iveyj1/nrfstick/data/download.pdf

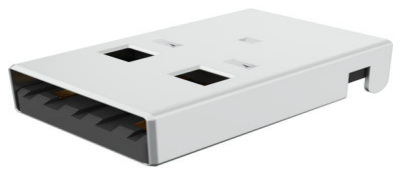
[picture p1: figure]

Part Number : 480372100 (https://www.molex.com/en-us/products/part-detail/480372100)
Product Description : Universal Serial Bus (USB) Shielded I/O Plug, Type A, Right-Angle, Surface Mount, Straight Tab 4.80mm, 0.76µm Gold (Au) Plating, PCB Thickness 1.60mm, Tape on Reel Package, Lead-Free Series Number : 48037
Status : Active
Product Category : I/O Connectors

### Documents and Resources

Drawings
480372100_sd.pdf (https://www.molex.com/content/dam/molex/molex-dot-com/products/automated/en-us/salesdrawingpdf/480/48037/480372100_sd.pdf)
PK-48037-210-002.pdf (https://www.molex.com/content/dam/molex/molex-dot-com/products/automated/en-us/packagingdesigndrawing/480/48037/PK-48037-210-002.pdf)
3D Models and Design Files STEP (https://www.molex.com/bin/molex/traceparts/cad-request?partNumber=480372100&cadFormatId=659) AP242 (https://www.molex.com/bin/molex/traceparts/cad-request?partNumber=480372100&cadFormatId=659)
SOLIDWORKS (https://www.molex.com/bin/molex/traceparts/cad-request?partNumber=480372100&cadFormatId=7)
Creo (https://www.molex.com/bin/molex/traceparts/cad-request?partNumber=480372100&cadFormatId=16)
Symbol (https://www.molex.com/en-us/products/part-3d-cad/480372100) and (https://www.molex.com/en-us/products/part-3d-cad/480372100) Footprint (https://www.molex.com/en-us/products/part-3d-cad/480372100) (Multi- (https://www.molex.com/en-us/products/part-3d-cad/480372100)Format) (https://www.molex.com/en-us/products/part-3d-cad/480372100) Specifications
PS-48037-001-001.pdf (https://www.molex.com/content/dam/molex/molex-dot-com/products/automated/en-us/productspecificationpdf/480/48037/PS-48037-001-001.pdf)
TS-48037-001-001.pdf (https://www.molex.com/content/dam/molex/molex-dot-com/products/automated/en-us/productspecificationpdf/480/48037/TS-48037-001-001.pdf)

### Product Environment Compliance

Compliance
GADSL/IMDS | Compliant with Exemption 33
China RoHS | per SJ/T 11365-2006
EU ELV | Not Relevant
Low-Halogen Status | Low-Halogen per IEC 61249-2-21
REACH SVHC | Not Contained per D(2025)7771-DC (04 Feb 2026)
EU RoHS | Compliant per EU 2015/863

Compliance (https://www.molex.com/en-us/product-compliance#pn=480372100) Statements (https://www.molex.com/en-us/product-compliance#pn=480372100)
EU RoHS
REACH SVHC
Low-Halogen
Industry (https://www.molex.com/en-us/industry-compliance?pn=480372100) Documents (https://www.molex.com/en-us/industry-compliance?pn=480372100)
IPC 1752A Class C
IPC 1752A Class D
Molex Product Compliance Declaration IEC-62474
chemSHERPA (xml)
Substances (https://www.molex.com/en-us/substances-of-interest?pn=480372100) of (https://www.molex.com/en-us/substances-of-interest?pn=480372100) Interest (https://www.molex.com/en-us/substances-of-interest?pn=480372100)
PFAS
EU (https://www.molex.com/en-us/rohs-pdf?pn=480372100) RoHS (https://www.molex.com/en-us/rohs-pdf?pn=480372100) Certificate (https://www.molex.com/en-us/rohs-pdf?pn=480372100) of (https://www.molex.com/en-us/rohs-pdf?pn=480372100) Compliance (https://www.molex.com/en-us/rohs-pdf?pn=480372100) Additional (https://www.molex.com/en-us/about/product-compliance) Product (https://www.molex.com/en-us/about/product-compliance) Compliance (https://www.molex.com/en-us/about/product-compliance) Information (https://www.molex.com/en-us/about/product-compliance)

### Part Details

General
Status | Active
Category | I/O Connectors
Series | 48037
Description | Universal Serial Bus (USB) Shielded I/O Plug, Type A, Right-Angle, Surface Mount, Straight Tab 4.80mm, 0.76µm Gold (Au) Plating, PCB Thickness 1.60mm, Tape on Reel Package, Lead-Free
Application | Wire-to-Board
Comments | Straight Tab 4.80mm
Component Type | Plug
Product Name | USB
Standard | USB 2.0
Type | A
UPC | 822350302760

Electrical
Current - Maximum per Contact | 1.5A
Shielded | Yes
Shield Type | Full Shield

Voltage - Maximum | 150V AC (RMS)

Physical
Circuits (Loaded) | 4
Circuits (maximum) | 4
Color - Resin | Black
Gender | Male
Keying to Mating Part | Yes
Lock to Mating Part | Yes
Material - Metal | Brass
Material - Plating Mating | Gold
Material - Plating Termination | Tin
Mounting Style | Top-Mount
Net Weight | 1.908/g
Number of Rows | 1
Orientation | Right Angle
Packaging Type | Embossed Tape on Reel
Panel Mount | Yes
PCB Locator | Yes
PCB Retention | Yes
PCB Thickness - Recommended | 1.60mm
Pitch - Mating Interface | 2.00mm, 2.50mm
Pitch - Termination Interface | 2.00mm, 2.50mm
Plating min - Mating | 0.762µm
Polarized to Mating Part | Yes
Polarized to PCB | Yes
Ports | 1
Temperature Range - Operating | -20° to +85°C
Termination Interface Style | Surface Mount
Waterproof / Dustproof | No

### Mates With / Use With

Mates with Part(s)
Description | Part Number

Mates With | USB Type A Receptacle
| This document was generated on Jun 28, 2026
