iveyj1/nrfstick/kikit/nrfstick-panel.png

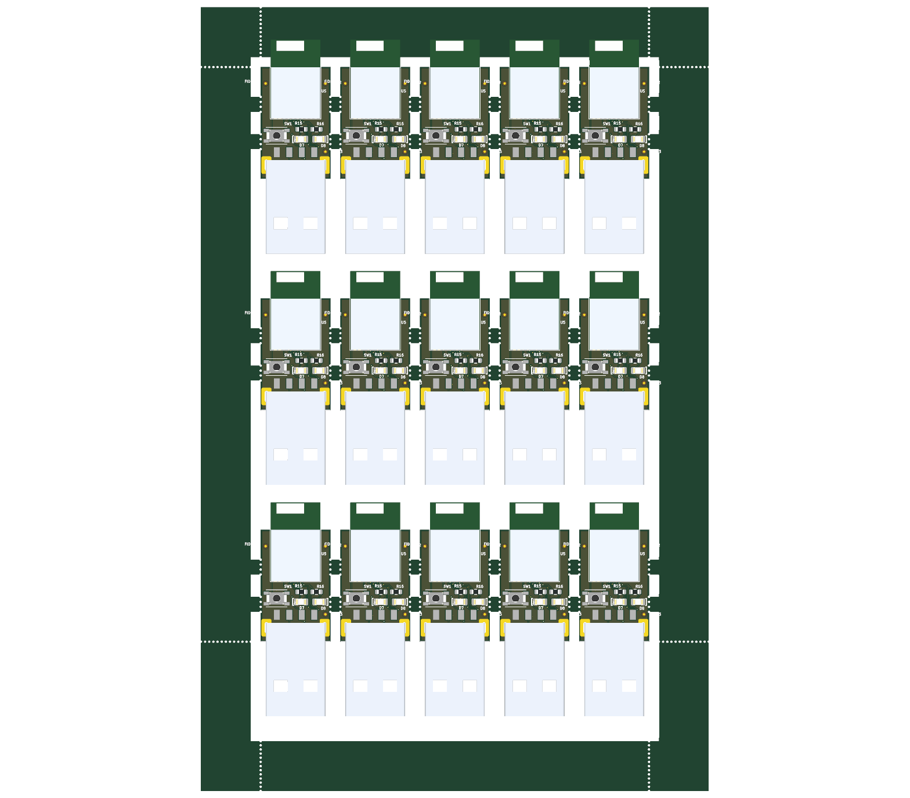
kikit/nrfstick-panel.png
