iveyj1/nrfstick/cad/adamtech_usb_ap_s_ra_smt.step

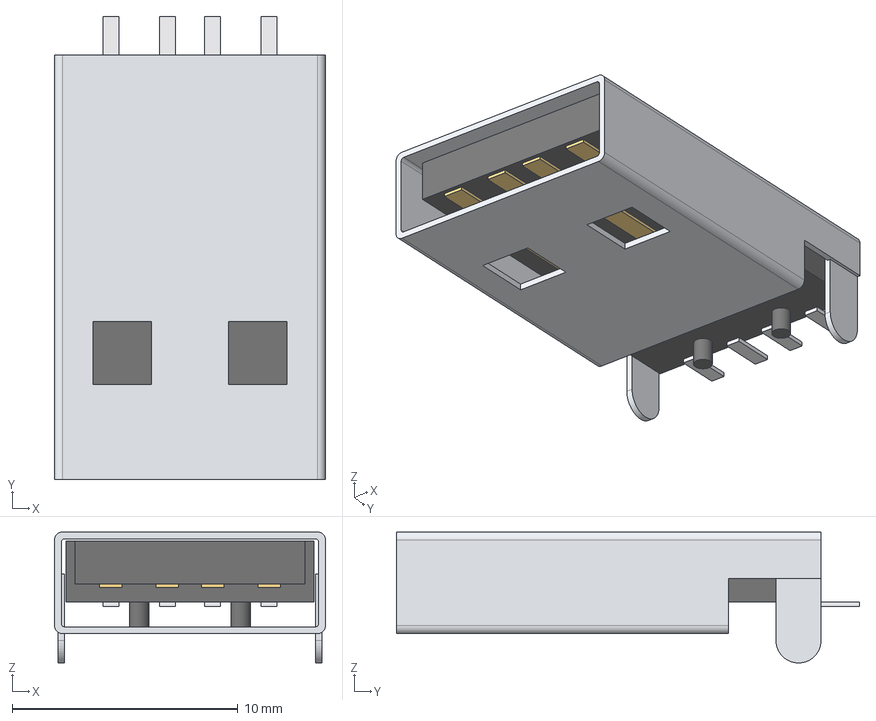
[picture p3: CAD file, 2026-09-16]
cad/adamtech_usb_ap_s_ra_smt.step
12.0 x 20.5 x 5.80 mm
nickel_shell
black_insulator
tin_tail_1
gold_contact_1
tin_tail_2
gold_contact_2
tin_tail_3
gold_contact_3
tin_tail_4
gold_contact_4
