iveyj1/nrfstick/kikit/cad/molex_480372100.step

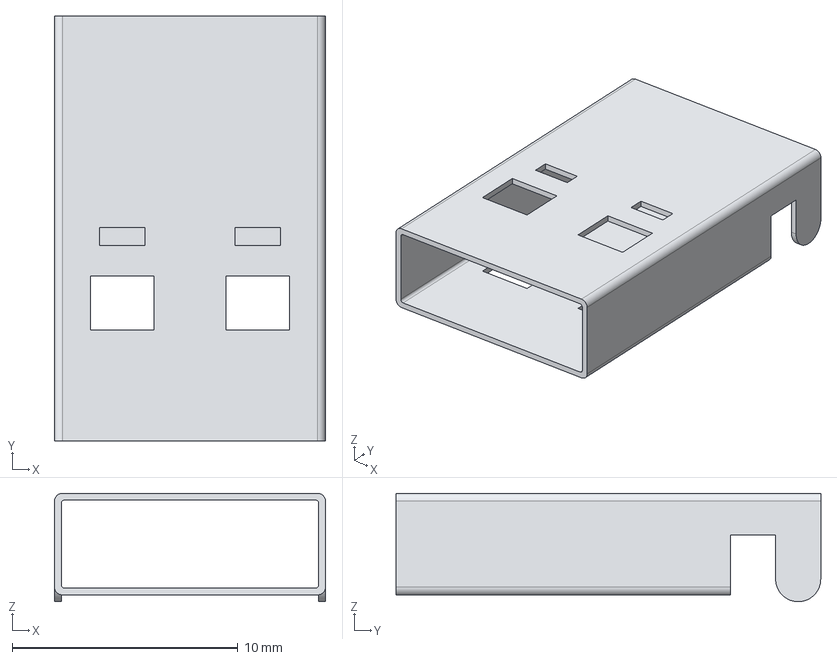
[picture p4: CAD file, 2026-09-16]
kikit/cad/molex_480372100.step
12.0 x 18.8 x 4.80 mm
