iveyj1/nrfstick/cad/fanstel_bm15c.step

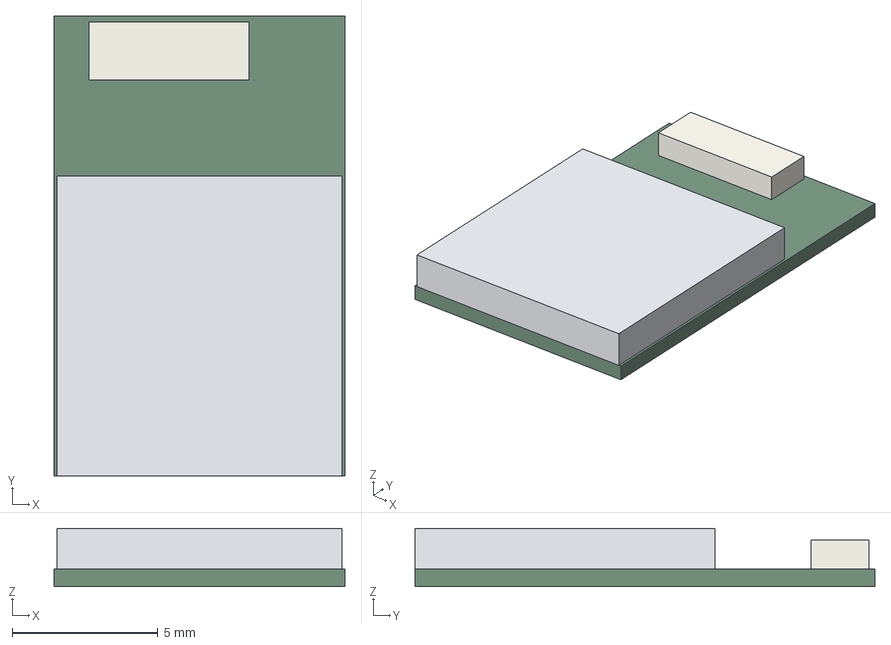
[picture p5: CAD file, 2026-09-16]
cad/fanstel_bm15c.step
10.0 x 15.8 x 2.00 mm
module_PCB
RF_shield
chip_antenna
