iveyj1/nrfstick/cad/nrfstick_board_support.step

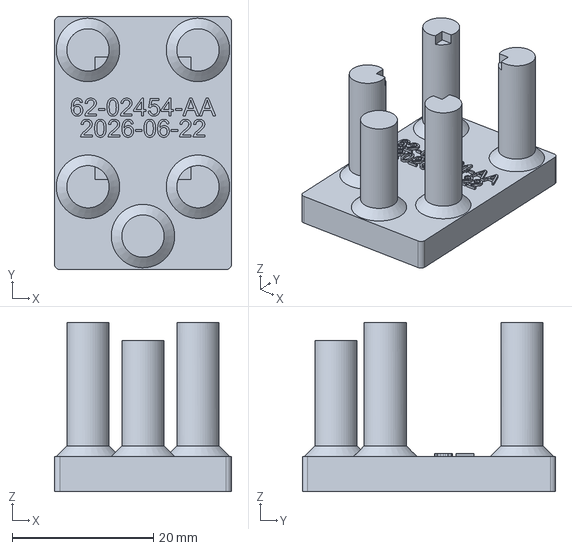
[picture p6: CAD file, 2026-08-20]
cad/nrfstick_board_support.step
25.1 x 35.9 x 24.0 mm
