iveyj1/nrfstick/cad/nrfstick_pcb_preview.step

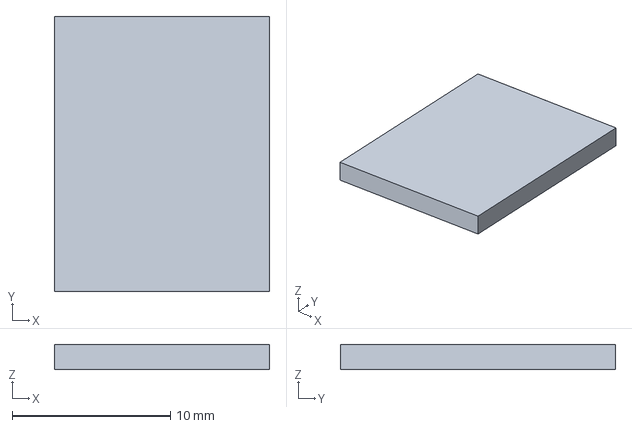
[picture p7: CAD file, 2026-08-20]
cad/nrfstick_pcb_preview.step
13.6 x 17.4 x 1.60 mm
