iveyj1/nrfstick/(list of files, cad)

Other CAD files:
cad/nrfstick_board_support.3mf
