iveyj1/nrfstick/(list of files, drawings)

Other design files:
freerouting.dsn
temp-freerouting.dsn
