iveyj1/nrfstick/nrfstick.kicad_pcb

## KiCad design nrfstick.kicad_pcb (2026-09-16)

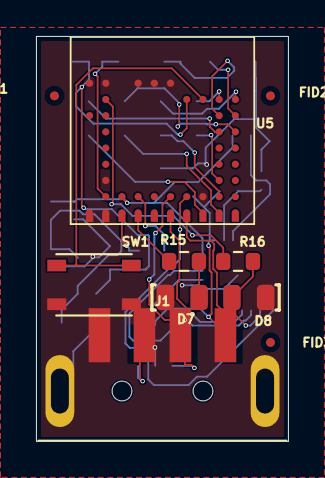
[picture p8: board nrfstick.kicad_pcb from above]

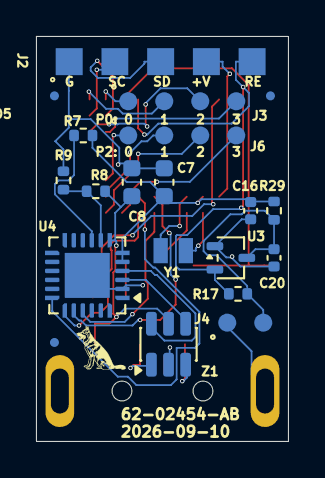
[picture p9: board nrfstick.kicad_pcb from below]

Board: 4 copper layers, 14.0 x 22.5 mm, 31 parts (21 on the bottom side), 32 nets.

Parts:
C7, C8: 4.7uF/10V; C_0603_1608Metric
C16, C20: 0.10uF/50v; C_0402_1005Metric
D7: BLUE LED; LED_0805_2012Metric
D8: RED LED; LED_0805_2012Metric
FID1, FID2, FID3, FID4, FID5, FID6: Fiducial; Fiducial_0.5mm_Mask1mm
H2: Shepherd; shepherd-neg
J1: USB_A; USB_A_AdamTech_USB-AP-S-RA-SMT
J2: programming conn; program-nrf
J3: IO00; Conn_Pads_1x04_P2.00mm_D1.00mm
J4: Reset; Conn_Pads_2x01_P2.00mm_D1.00mm
J6: UART2; Conn_Pads_1x04_P2.00mm_D1.00mm
R7, R29: 1.00k; R_0402_1005Metric
R8: 22.1k; R_0402_1005Metric
R9: 47.5k; R_0402_1005Metric
R15: 47/0603/0.125W; R_0603_1608Metric
R16: 270/0603/0.125W; R_0603_1608Metric
R17: 100K; R_0402_1005Metric
SW1: SKRPABE010; SW_Push_Alps_SKRPABE010
U3: APX803L20-27SR-7; SOT-323_SC-70
U4: CP2102C-Axx-xQFN24; QFN-24-1EP_4x4mm_P0.5mm_EP2.5x2.5mm
U5: BM15C; Fanstel_BM15C
Y1: 32.768kHz; Crystal_2-SMD_EPSON_FC2012SN
Z1: USBLC6-2SC6; SOT-23-6

Connections:
+5V: C8.2, J1.1 (VBUS), R8.1, U4.7 (VREGIN), Z1.5 (VBUS)
/BUTTON: SW1.2, U5.H2 (P0.04)
/LED_BLUE: R15.1, U5.D9 (P1.02/NFC)
/LED_RED: R16.1, U5.B2 (P1.10)
/P1.00/XTAL: U5.D8 (P1.00/XTAL), Y1.2
/P1.01/XTAL: U5.C9 (P1.01/XTAL), Y1.1
/UART_nRF_CTS: U4.19 (~RTS), U5.G9 (P1.07/AIN3)
/UART_nRF_RTS: U4.18 (~CTS), U5.G8 (P1.08)
/UART_nRF_RX: U4.21 (TXD), U5.F9 (P1.06/AIN2)
/UART_nRF_TX: U4.20 (RXD), U5.F8 (P1.05/AIN1)
/~RESET: J2.5, R17.1, U3.2 (~RESET), U5.G2 (~RESET)
GND: C7.1, C8.1, C16.1, C20.1, D7.1 (K), D8.1 (K), J1.4 (GND), J1.SH (Shield), J2.1, J4.1, R9.2, SW1.1, U3.1 (GND), U4.2 (GND), U4.25 (GND), U5.A1 (GND), U5.A9 (GND), U5.B1 (GND), U5.B7 (GND), U5.B9 (GND), U5.D1 (GND), U5.E1 (GND), U5.F1 (GND), U5.H8 (GND), Z1.2 (eGND)
unnamed: D7.2 (A), R15.2
unnamed: D8.2 (A), R16.2
unnamed: J1.3 (D+), Z1.3 (I/O2)
unnamed: J1.2 (D-), Z1.1 (I/O1)
unnamed: J2.2, U5.K3 (SWDCLK)
unnamed: J2.3, U5.J3 (SWDIO)
unnamed: J3.1, U5.J2 (P0.03)
unnamed: J3.2, U5.K2 (P0.02)
unnamed: J3.3, U5.K4 (P0.01)
unnamed: J3.4, U5.J4 (P0.00)
unnamed: C20.2, J4.2, R17.2, R29.2, U3.3 (VCC)
unnamed: J6.1, U5.J7 (P2.03)
unnamed: J6.2, U5.J8 (P2.02)
unnamed: J6.3, U5.J9 (P2.01)
unnamed: J6.4, U5.H9 (P2.00)
unnamed: U4.3 (D+), Z1.4 (I/O2)
unnamed: U4.4 (D-), Z1.6 (I/O1)
unnamed: R8.2, R9.1, U4.8 (VBUS)
unnamed: R7.2, U4.9 (~RST)
VDD: C7.2, C16.2, J2.4, R7.1, R29.1, U4.5 (VIO), U4.6 (VDD), U5.B8 (VDD), U5.C8 (VDDM)
