iveyj1/nrfstick/(commit log)

2026-06-20 shrunk, routed, passes drc, no checklist yet
    [nrf54l15-stick-B_Cu.gbr, nrf54l15-stick-B_Mask.gbr, nrf54l15-stick-B_Paste.gbr, nrf54l15-stick-B_Silkscreen.gbr, nrf54l15-stick-Edge_Cuts.gbr, nrf54l15-stick-F_Cu.gbr, nrf54l15-stick-F_Mask.gbr, nrf54l15-stick-F_Paste.gbr]
2026-06-28 fixed design net rules, passes drc
    [nrf54l15-stick-B_Cu.gbr, nrf54l15-stick-B_Mask.gbr, nrf54l15-stick-B_Paste.gbr, nrf54l15-stick-B_Silkscreen.gbr, nrf54l15-stick-Edge_Cuts.gbr, nrf54l15-stick-F_Cu.gbr, nrf54l15-stick-F_Mask.gbr, nrf54l15-stick-F_Paste.gbr]
2026-06-29 add MPNs to schematic
    [i2c_interface.kicad_sch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]
2026-07-19 add board support cad
    [nrfstick.kicad_pcb, nrfstick_board_support.3mf, nrfstick_board_support.step, nrfstick_pcb_preview.step]
2026-08-17 pcb support fixture cad
2026-08-20 Start AB changes - add RTS/CTS
    squash
    [nrfstick.kicad_sch, nrfstick_board_support.step, nrfstick_pcb_preview.step]
2026-09-10 Replace SW4 with Alps SKRPABE010 and save revised PCB layout
    [nrfstick.kicad_pcb, nrfstick.kicad_sch]
2026-09-16 panel layout using kikit, not routed
    [fanstel_bm15c.step, freerouting.dsn, molex_480372100.step, nrfstick-panel.kicad_pcb, nrfstick.kicad_pcb, nrfstick.kicad_sch]
2026-09-16 panelize, new usb connector
    [adamtech_usb_ap_s_ra_smt.step, molex_480372100.step, nrfstick-panel.kicad_pcb, nrfstick.kicad_pcb, nrfstick.kicad_sch, temp-freerouting.dsn]
